baldengineer/C64-Pi-Pico-USB-Keyboard-Adapter/KiCad/C64-Pi Pico USB Keyboard rev1 ray render.png

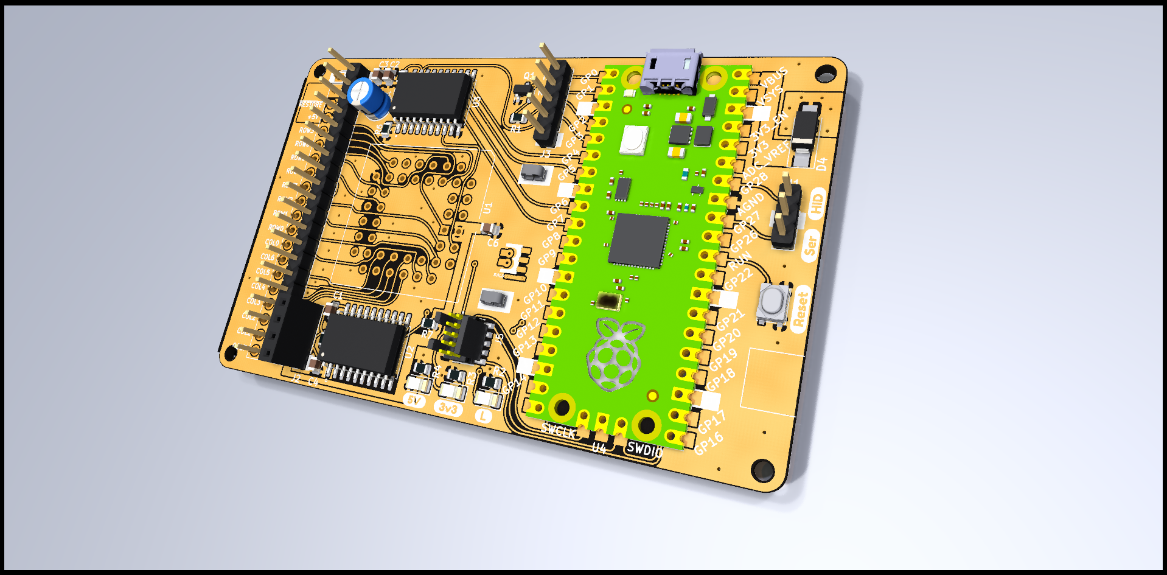
KiCad/C64-Pi Pico USB Keyboard rev1 ray render.png
