baldengineer/C64-Pi-Pico-USB-Keyboard-Adapter/README.md

Here's a mirror for the [MT8816 Datasheet](https://bald.ee/mt8816).
