baldengineer/C64-Pi-Pico-USB-Keyboard-Adapter/KiCad/C64-Pi Pico USB Keyboard.kicad_pcb

## KiCad design KiCad/C64-Pi Pico USB Keyboard.kicad_pcb (2022-09-05)

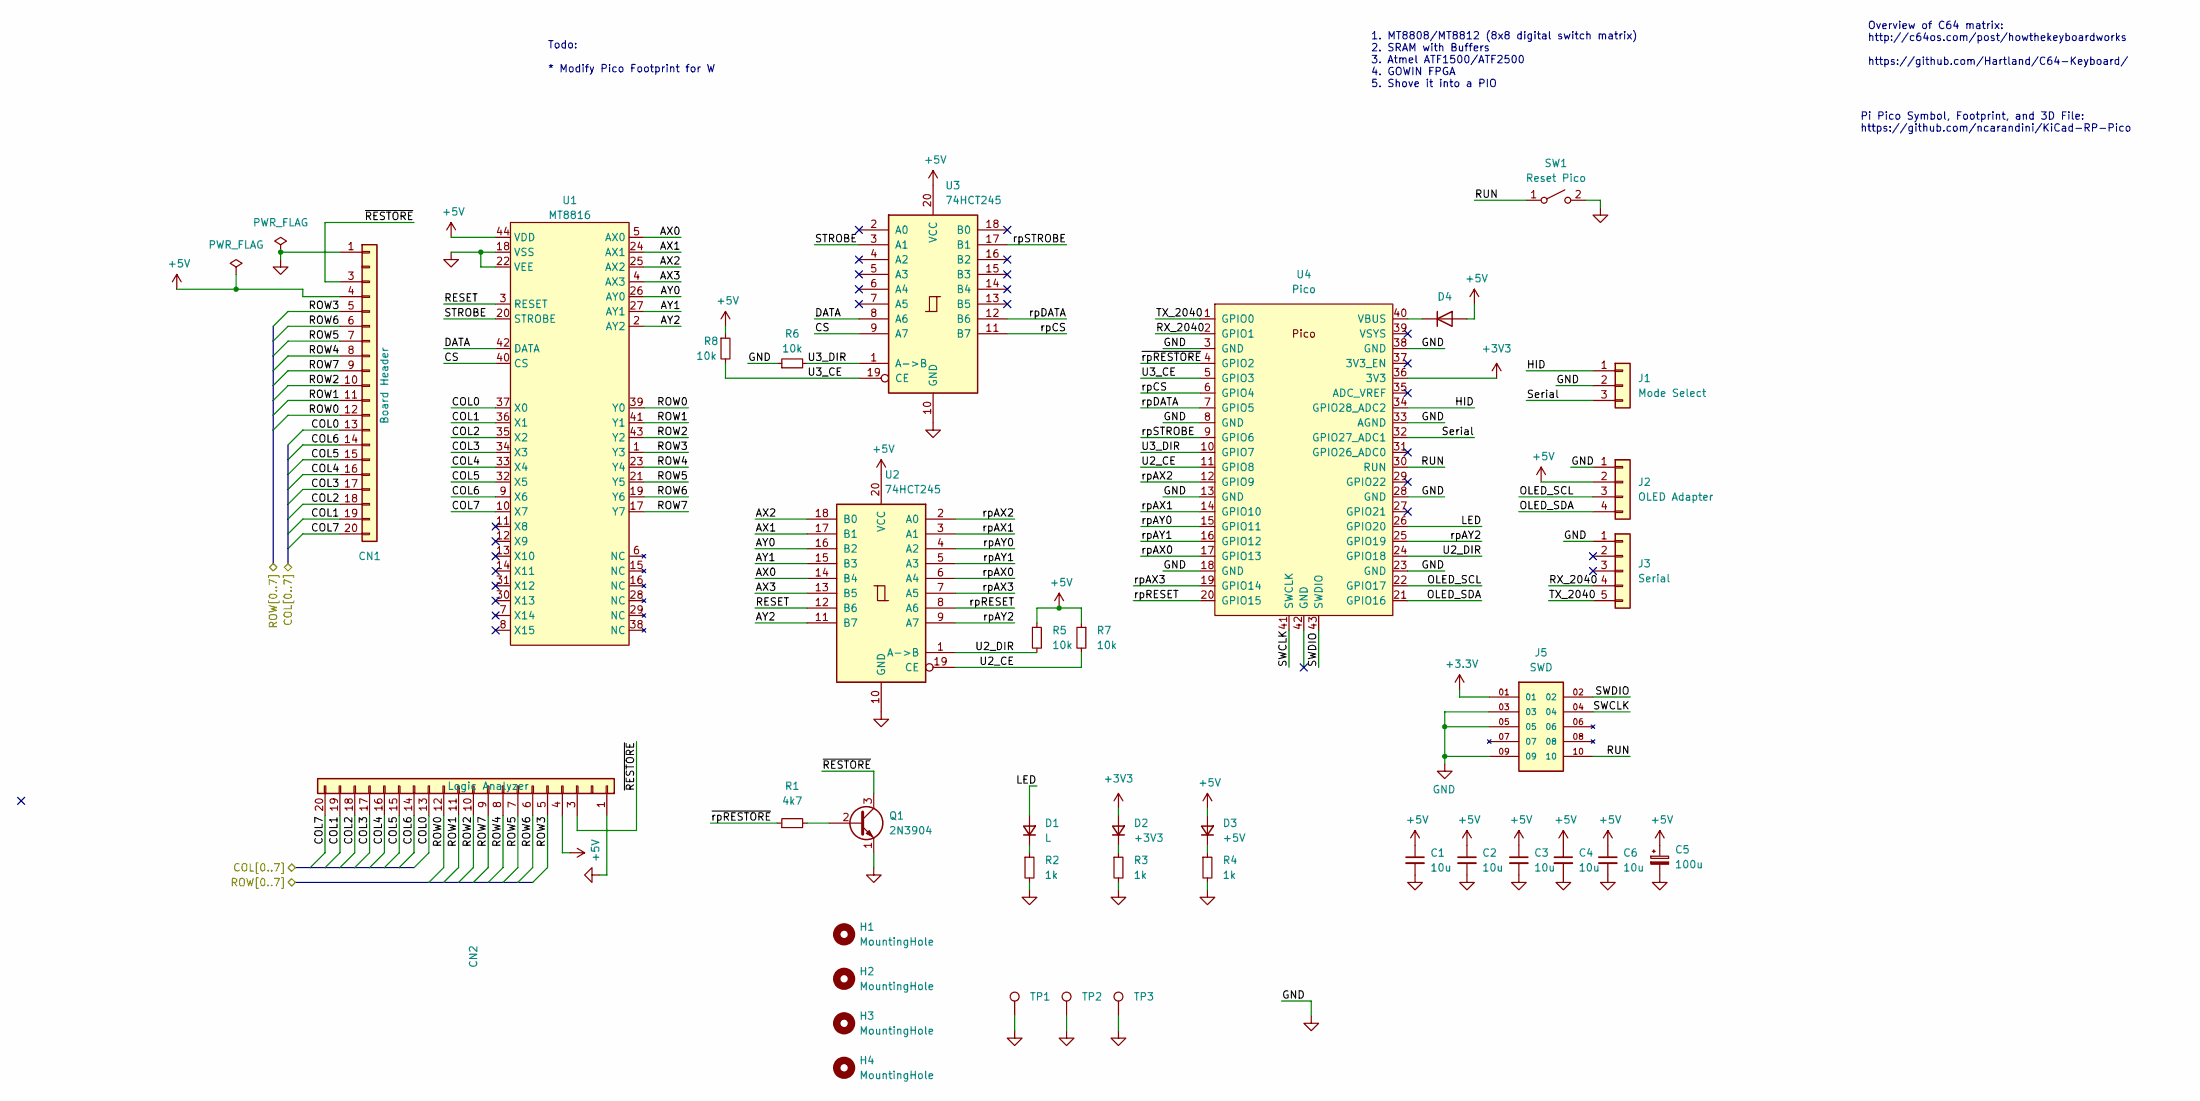
[picture p2: schematic C64-Pi Pico USB Keyboard.kicad_sch, PicoW USB Adapter for C64]

Parts:
C1, C2, C3, C4, C6: 10u; C_0805_2012Metric
C5: 100u; CP_Radial_D5.0mm_P2.50mm
CN1: Board Header; PinSocket_1x20_P2.54mm_Vertical
CN2: Logic Analyzer; PinHeader_1x20_P2.54mm_Vertical
D1: L; LED_1206_3216Metric
D2: +3V3; LED_1206_3216Metric
D3: +5V; LED_1206_3216Metric
D4: SM4001; D_SMA_Handsoldering
H1, H2, H3, H4: MountingHole; MountingHole_2.2mm_M2
J1: Mode Select; PinHeader_1x03_P2.54mm_Vertical
J2: OLED Adapter; PinSocket_1x04_P2.54mm_Vertical
J3: Serial; PinHeader_1x05_P2.54mm_Vertical
J5: SWD; SAMTEC_FTSH-105-XX-X-DV; PARTREV H
Q1: 2N3904; SOT-23
R1: 4k7; R_0805_2012Metric
R2, R3, R4: 1k; R_0805_2012Metric
R5, R6, R7, R8: 10k; R_0805_2012Metric
SW1: Reset Pico; SW_SPST_PTS810
TP1, TP2, TP3: TestPoint_Harwin; Harwin-S1751-46-Test-Point
U1: MT8816; PLCC-44_THT-Socket
U2, U3: 74HCT245; SOIC-20W_7.5x12.8mm_P1.27mm
U4: Pico; RPi_Pico_W_Combined_SMD_TH

Connections:
+5V: C1.1, C2.1, C3.1, C4.1, C5.1, C6.1, CN1.4, CN2.4, D3.2 (A), D4.2 (A), J2.2, R5.1, R7.1, R8.1, U1.44 (VDD), U2.20 (VCC), U3.20 (VCC)
/AX0: U1.5 (AX0), U2.14 (B4)
/AX1: U1.24 (AX1), U2.17 (B1)
/AX2: U1.25 (AX2), U2.18 (B0)
/AX3: U1.4 (AX3), U2.13 (B5)
/AY0: U1.26 (AY0), U2.16 (B2)
/AY1: U1.27 (AY1), U2.15 (B3)
/AY2: U1.2 (AY2), U2.11 (B7)
/COL0: CN1.13, CN2.13, U1.37 (X0)
/COL1: CN1.19, CN2.19, U1.36 (X1)
/COL2: CN1.18, CN2.18, U1.35 (X2)
/COL3: CN1.17, CN2.17, U1.34 (X3)
/COL4: CN1.16, CN2.16, U1.33 (X4)
/COL5: CN1.15, CN2.15, U1.32 (X5)
/COL6: CN1.14, CN2.14, U1.9 (X6)
/COL7: CN1.20, CN2.20, U1.10 (X7)
/CS: U1.40 (CS), U3.9 (A7)
/DATA: U1.42 (DATA), U3.8 (A6)
/HID: J1.1, U4.34 (GPIO28_ADC2)
/LED: D1.2 (A), U4.26 (GPIO20)
/OLED_SCL: J2.3, U4.22 (GPIO17)
/OLED_SDA: J2.4, U4.21 (GPIO16)
/RESET: U1.3 (RESET), U2.12 (B6)
/ROW0: CN1.12, CN2.12, U1.39 (Y0)
/ROW1: CN1.11, CN2.11, U1.41 (Y1)
/ROW2: CN1.10, CN2.10, U1.43 (Y2)
/ROW3: CN1.5, CN2.5, U1.1 (Y3)
/ROW4: CN1.8, CN2.8, U1.23 (Y4)
/ROW5: CN1.7, CN2.7, U1.21 (Y5)
/ROW6: CN1.6, CN2.6, U1.19 (Y6)
/ROW7: CN1.9, CN2.9, U1.17 (Y7)
/RUN: J5.10, SW1.1 (A), U4.30 (RUN)
/RX_2040: J3.4, U4.2 (GPIO1)
/STROBE: U1.20 (STROBE), U3.3 (A1)
/SWCLK: J5.04, U4.41 (SWCLK)
/SWDIO: J5.02, U4.43 (SWDIO)
/Serial: J1.3, U4.32 (GPIO27_ADC1)
/TX_2040: J3.5, U4.1 (GPIO0)
/U2_CE: R7.2, U2.19 (CE), U4.11 (GPIO8)
/U2_DIR: R5.2, U2.1 (A->B), U4.24 (GPIO18)
/U3_CE: R8.2, U3.19 (CE), U4.5 (GPIO3)
/U3_DIR: R6.2, U3.1 (A->B), U4.10 (GPIO7)
/rpAX0: U2.6 (A4), U4.17 (GPIO13)
/rpAX1: U2.3 (A1), U4.14 (GPIO10)
/rpAX2: U2.2 (A0), U4.12 (GPIO9)
/rpAX3: U2.7 (A5), U4.19 (GPIO14)
/rpAY0: U2.4 (A2), U4.15 (GPIO11)
/rpAY1: U2.5 (A3), U4.16 (GPIO12)
/rpAY2: U2.9 (A7), U4.25 (GPIO19)
/rpCS: U3.11 (B7), U4.6 (GPIO4)
/rpDATA: U3.12 (B6), U4.7 (GPIO5)
/rpRESET: U2.8 (A6), U4.20 (GPIO15)
/rpSTROBE: U3.17 (B1), U4.9 (GPIO6)
/~RESTORE: CN1.3, CN2.3, Q1.3 (C)
/~rpRESTORE: R1.1, U4.4 (GPIO2)
GND: C1.2, C2.2, C3.2, C4.2, C5.2, C6.2, CN1.1, CN2.1, J1.2, J2.1, J3.1, J5.03, J5.05, J5.09, Q1.1 (E), R2.2, R3.2, R4.2, R6.1, SW1.2 (B), TP1.1, TP2.1, TP3.1, U1.18 (VSS), U1.22 (VEE), U2.10 (GND), U3.10 (GND), U4.3 (GND), U4.8 (GND), U4.13 (GND), U4.18 (GND), U4.23 (GND), U4.28 (GND), U4.33 (AGND), U4.38 (GND)
unnamed: D1.1 (K), R2.1
unnamed: D2.1 (K), R3.1
unnamed: D3.1 (K), R4.1
unnamed: D4.1 (K), U4.40 (VBUS)
unnamed: Q1.2 (B), R1.2

Notes on the sheet:
Pi Pico Symbol, Footprint, and 3D File: https://github.com/ncarandini/KiCad-RP-Pico
Todo: * Modify Pico Footprint for W
Overview of C64 matrix: http://c64os.com/post/howthekeyboardworks https://github.com/Hartland/C64-Keyboard/
1. MT8808/MT8812 (8x8 digital switch matrix) 2. SRAM with Buffers 3. Atmel ATF1500/ATF2500 4. GOWIN FPGA 5. Shove it into a PIO

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
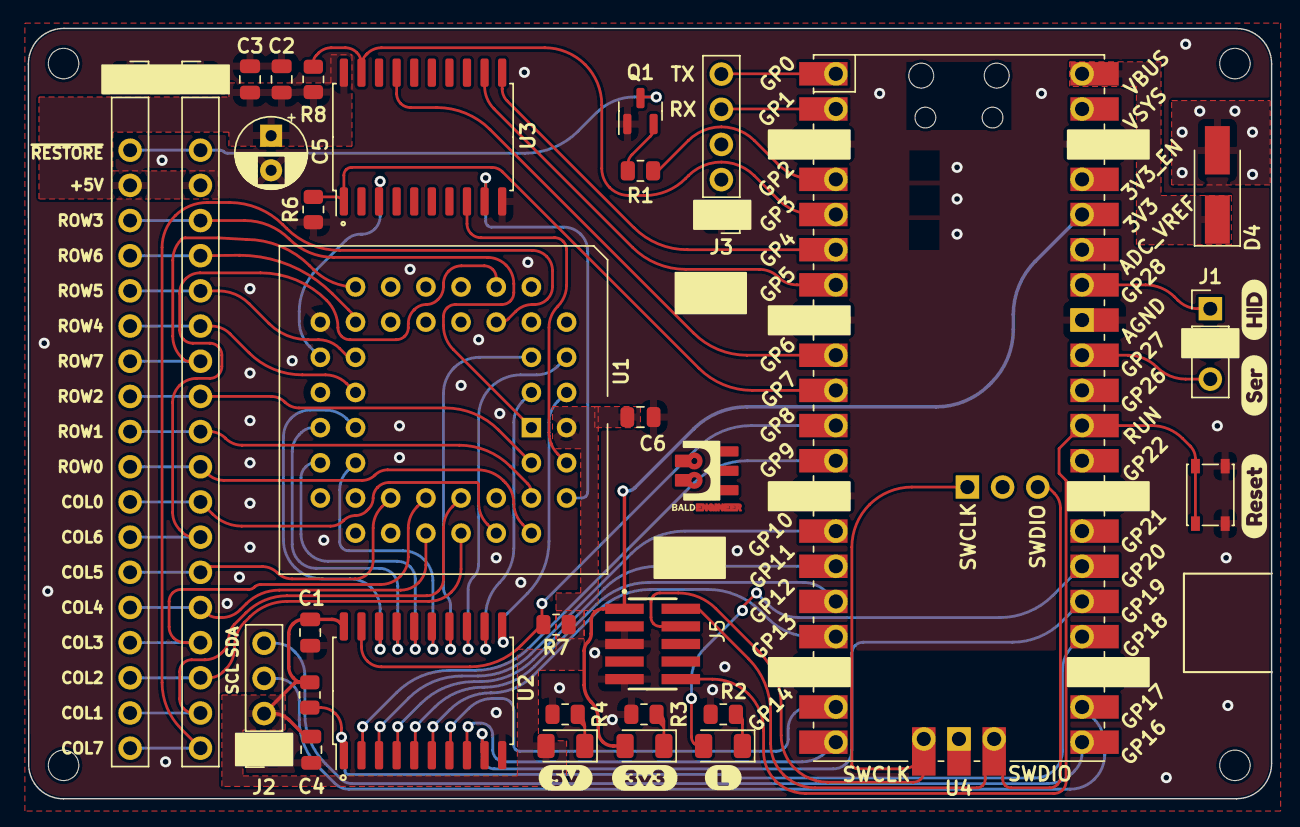
[picture p3: board C64-Pi Pico USB Keyboard.kicad_pcb from above]

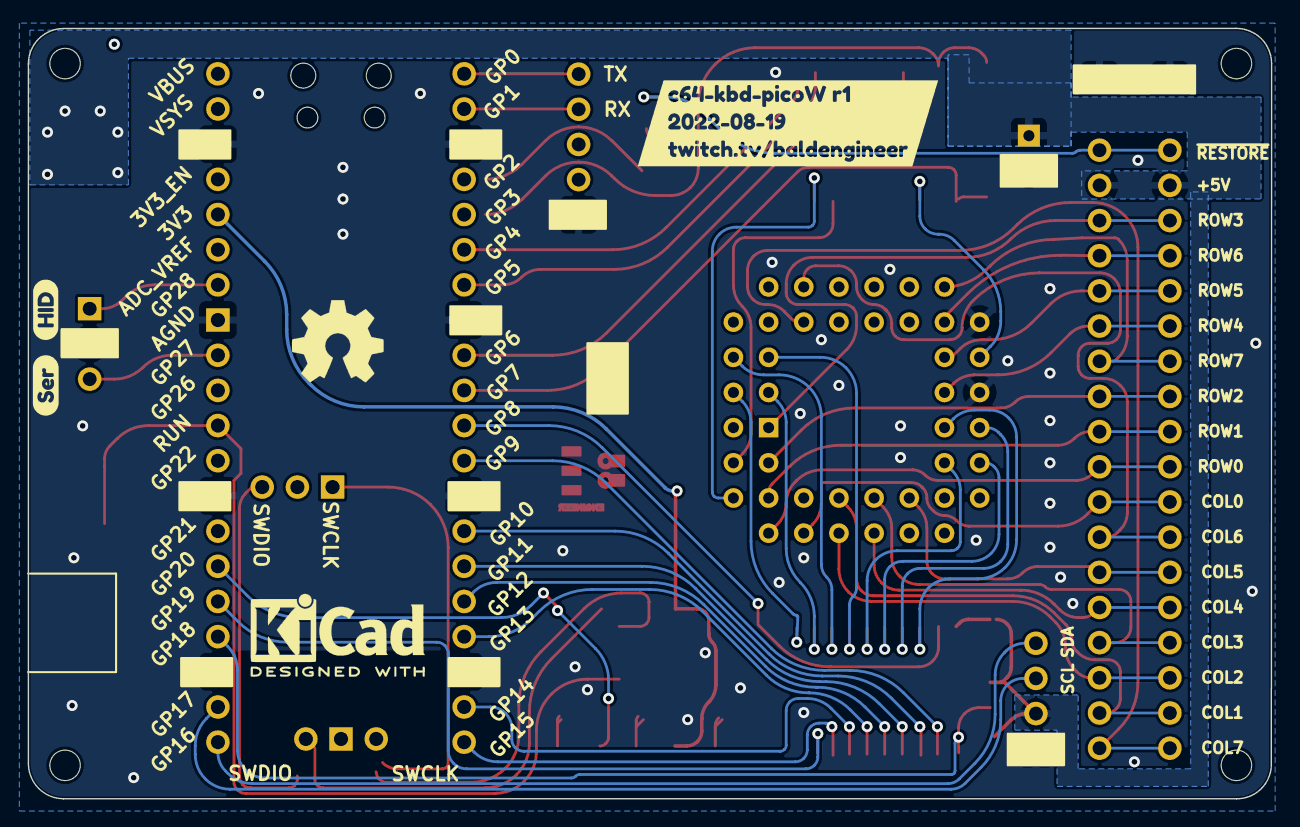
[picture p4: board C64-Pi Pico USB Keyboard.kicad_pcb from below]

Board: 2 copper layers, 89.8 x 55.6 mm, 47 parts (4 on the bottom side), 62 nets.

Other parts of the board:
kibuzzard-62FFC0C4: G***; kibuzzard-62FFC0C4
kibuzzard-62FFC0CE: G***; kibuzzard-62FFC0CE
kibuzzard-62FFC8C1: G***; kibuzzard-62FFC8C1
kibuzzard-62FFC8D3, kibuzzard-62FFC8D3#2: G***; kibuzzard-62FFC8D3
kibuzzard-62FFC8F9, kibuzzard-62FFC8F9#2: G***; kibuzzard-62FFC8F9
kibuzzard-62FFC032: G***; kibuzzard-62FFC032
kibuzzard-62FFC121: G***; kibuzzard-62FFC121
svg2mod: G***; BE5v2
